Lisa-zhu-zz65/ENG301/README.md

# Music Bracelet Project
Repository for the music bracelet project, with hardware and software work detailed. \
Project_1 folder contains all the files created and used in the music bracelet prototype.\
Project_2 folder contains all the files created for the music bracelet PCB design.
