Lisa-zhu-zz65/ENG301/Project_2/docs/Lisa Zhu Project 2 proposal.pptx

## ENGI 301 <Music Bracelet> PCB Proposal

<Nov 16th 2021>
<Lisa Zhu>

## Background Information

- What is being proposed?
  - Lisa-zhu-zz65/ENGI301 (github.com) (https://github.com/Lisa-zhu-zz65/ENGI301)
  - Music Bracelet - Hackster.io (https://www.hackster.io/lisa-zhu/music-bracelet-0456b9)
- What changes (if any) are you going to make based on your prototype?
  - Change the USB speaker to a Bluetooth speaker
  - Get power from a battery instead of wall outlet
  - Reduce the size of the screen
  - Smaller Breadboard

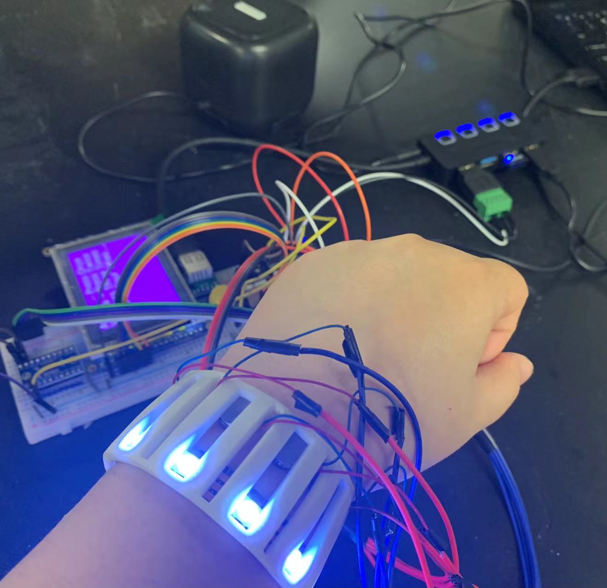
[picture p1: figure]

## System Block Diagram

Battery

Pocket Beagle

RGB LED Strip

VIN

VOUT

SPI

GND

PWM

Vibrating Mini Motor Discs

USB breakout board

Bluetooth Adaptor

Button

GPIO

USB1

Adafruit 1.8" TFT Display Breakout and Shield

SPI

## Mechanical Block Diagram

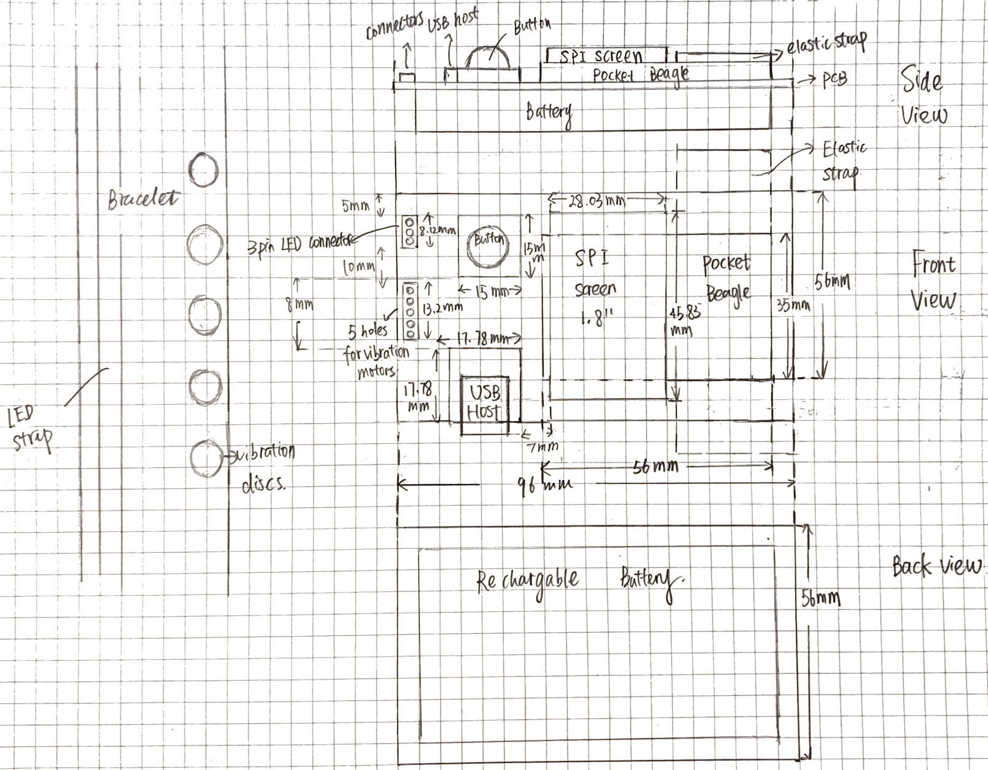
[picture p2: figure]

## Components Required

- Create a list of all the components that you require for the PCB
  - USB Host connector
  - TXS0108E Level Shifter
  - Power connector
  - 3-pin 100-mil Strip LED connector
  - LED strip
  - Button
  - Bluetooth adaptor
  - 1.8" TFT Display Breakout and Shield
  - Vibration discs
