Lisa-zhu-zz65/ENG301/Project_1/docs/Zhu_ENGI301_project_proposal.pptx

## ENGI 301 Haptic Music Player Proposal

10/5/2021
Lisa Zhu

## Background Information

- What is being proposed?
  - I want to build a wearable haptic wristband that can produce vibration cues that enable the user to feel the music while listening to music; a LED strip is decorated on the wristband to provide visual effects in response to the music.
  - I am a rock fan and I really enjoy live house performances; the main reason is that in such environment, audience can feel the vibrations from the speaker and visual simulations in addition to audio effects, and the experience is more engaging. Now with the pandemic, it’s harder to “feel” the music in person, and I think the haptic wristband can bring that combination of senses back.
  - A rendering framework for producing vibration cues: https://www.syntacts.org/
  - Inspired by the project: Pocketbeagle (https://www.hackster.io/juliana-wang/pocketbeagle-led-music-visualizer-3e6c7c) LED Music Visualizer - Hackster.io (https://www.hackster.io/juliana-wang/pocketbeagle-led-music-visualizer-3e6c7c)
- What improvements / additions over existing project
  - The motivating project doesn’t have vibration units and isn’t portable/ wearable, which I’ll be improving in my project.

## System Block Diagram

Pocket Beagle

VOUT

RGB LED Strip

GND

SPI

Vibrating Mini Motor Discs

PWM

USB breakout board

USB to micro USB hub

USB speaker

Buttons

GPIO

USB1

SPI

Adafruit 2.0" 320x240 Color IPS TFT Display

## Power Block Diagram

Pocket Beagle

VOUT/3.3V

5V, rated current unknown

RGB LED Strip

VOUT

3.3V, <60 mA each

Vibrating Mini Motor Discs

3.3V

Adafruit 2.0" 320x240 Color IPS TFT Display

Work with 3.3-5V

USB speaker

5V, 2x2W

Notes: 500mA max

## Components / Budget

Component | Need to Buy | Cost
Vibrating Mini Motor Disc : ID 1201 : $1.95 : Adafruit Industries, Unique & fun DIY electronics and kits (https://www.adafruit.com/product/1201) | 6 | $1.95 each
Amazon.com : ALITOVE 3.2ft 60 Pixels WS2812B Individual Addressable RGB LED Strip Light Programmable WS2811 IC Built-in 5050 LED Rope Lamp DC5V Black PCB Non-Waterproof Compatible with Arduino, Raspberry Pi : Home & Kitchen (https://www.amazon.com/ALITOVE-Individual-Addressable-Programmable-Non-Waterproof/dp/B01MG49QKD?s=lamps-light) | 1 | $9.99
2.0 320x240 Color IPS TFT Display with microSD Card Breakout : ID 4311 : $19.95 : Adafruit Industries, Unique & fun DIY electronics and kits (https://www.adafruit.com/product/4311) | 1 | $19.95
Mini External USB Stereo Speaker : ID 3369 : $12.50 : Adafruit Industries, Unique & fun DIY electronics and kits (https://www.adafruit.com/product/3369) | 1 | $12.5
USB Mini Hub with Power Switch - OTG Micro-USB : ID 2991 : $5.95 : Adafruit Industries, Unique & fun DIY electronics and kits (https://www.adafruit.com/product/2991) | 1 | %5.95
USB Micro-B Breakout Board : ID 1833 : $1.50 : Adafruit Industries, Unique & fun DIY electronics and kits (https://www.adafruit.com/product/1833) | 1 | $1.5
Amazon.com: 4 Pieces Carpal Tunnel Wrist Brace, Wrist Compression Strap, Hand Brace Wraps for Adult Working Out, Adjustable Wrist Strap, Breathable Wristband for Weightlifting, Tennis, Golf and Fitness, Black : Health & Household (https://www.amazon.com/Compression-Adjustable-Breathable-Wristband-Weightlifting/dp/B092QBG462) | 1 | $6.99
