Lisa-zhu-zz65/ENG301/Project_2/MFG/bottom layer gerber.png

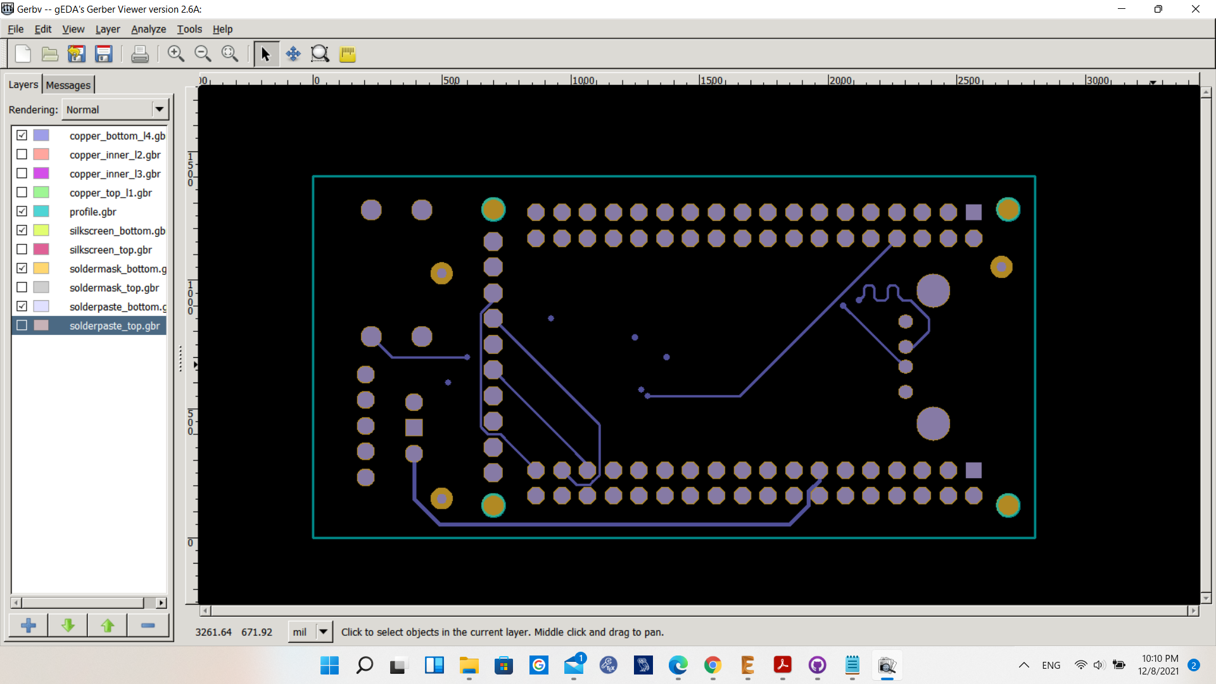
Project_2/MFG/bottom layer gerber.png
