Lisa-zhu-zz65/ENG301/Project_2/MFG/BOM.csv

Qty | Value | Device | Package | Parts | Description | AVAILABILITY | DESCRIPTION | HOUSEPART | MF | MP | MPN | PACKAGE | POPULATE | PRICE | PURCHASE-URL | TOLERANCE | URL | VOLTAGE
1 |  | CAPACITOR_P_10MM | CP10MM | C1 | Library: MF_Passives |  |  |  |  |  |  |  | 1
1 | 1k | R_R0603 | R0603 | R1 | RESISTOR, American symbol
6 | FIDUCIAL | FIDUCIAL | FIDUCIAL_40MIL | FUD1, FUD2, FUD3, FUD4, FUD5, FUD6
1 | LED_STRIP | LED_STRIP | LED_HEADERS | U2 | LED Strip
1 | POCKETBEAGLE | POCKETBEAGLE | POCKETBEAGLE | U1
1 | PUSH_BUTTON | PUSH_BUTTON | BUTTON_12.5MM | SW1
1 | SPI_DISPLAY | SPI_DISPLAY | SPI_DISPLAY | U3 | 1.8 Color TFT LCD display"
1 | TXS0108EPWR | TXS0108EPWR | SOP65P640X120-20N | U4 | Check prices | In Stock | 8-bit bidirectional voltage-level shifter for open-drain and push-pull application 20-TSSOP -40 to 85 |  | Texas Instruments | TXS0108EPWR |  | TSSOP-20 Texas Instruments |  | None | https://pricing.snapeda.com/search/part/TXS0108EPWR/?ref=eda
1 | USB_SPEAKER | USB_SPEAKER | USB_CONNECTOR | U5
1 | VIBRATOR | VIBRATOR | VIBRATOR_HEADERS | U6 | Vibration motor
