Lisa-zhu-zz65/ENG301/Project_2/project2_schematics.pdf

PocketBeagle | LED Strip | Level Shifter
3.3V P2_23 | SPI1.MOSI P2_25 | SPI1.MISO P2_27 | SPI1.CLK P2_29 | GPIO19 P2_31 | GPIO45 P2_33 | GPIO86 P2_35 | GPIO59 | P2_02 GPIO58 | P2_04 GPIO57 | P2_06 GPIO60 | P2_08 GPIO52 | P2_10 PWR.BTN P2_12 | BAT.VIN P2_14 | BAT.TEMP P2_16 | GPIO47 | P2_18 GPIO64 | P2_20 GPIO46 | P2_22 GPIO44 | P2_24 RESET# P2_26 | AIN.VREF- P1_17 | AIN0(1.8V) P1_19 | AIN1(1.8V) P1_21 | AIN2(1.8V) P1_23 | AIN3(1.8V) P1_25 | AIN4(1.8V) P1_27 | PRU0.7 | P1_29 PRU0.4 | P1_31 PWM0B | P1_33 PRU1.10 | P1_35 AIN.VREF+ P1_18 | PRU0.6 | P2_28 PRU0.3 | P2_30 PRU0.2 | P2_32 PRU0.5 | P2_34 AIN7(1.8V) P2_36

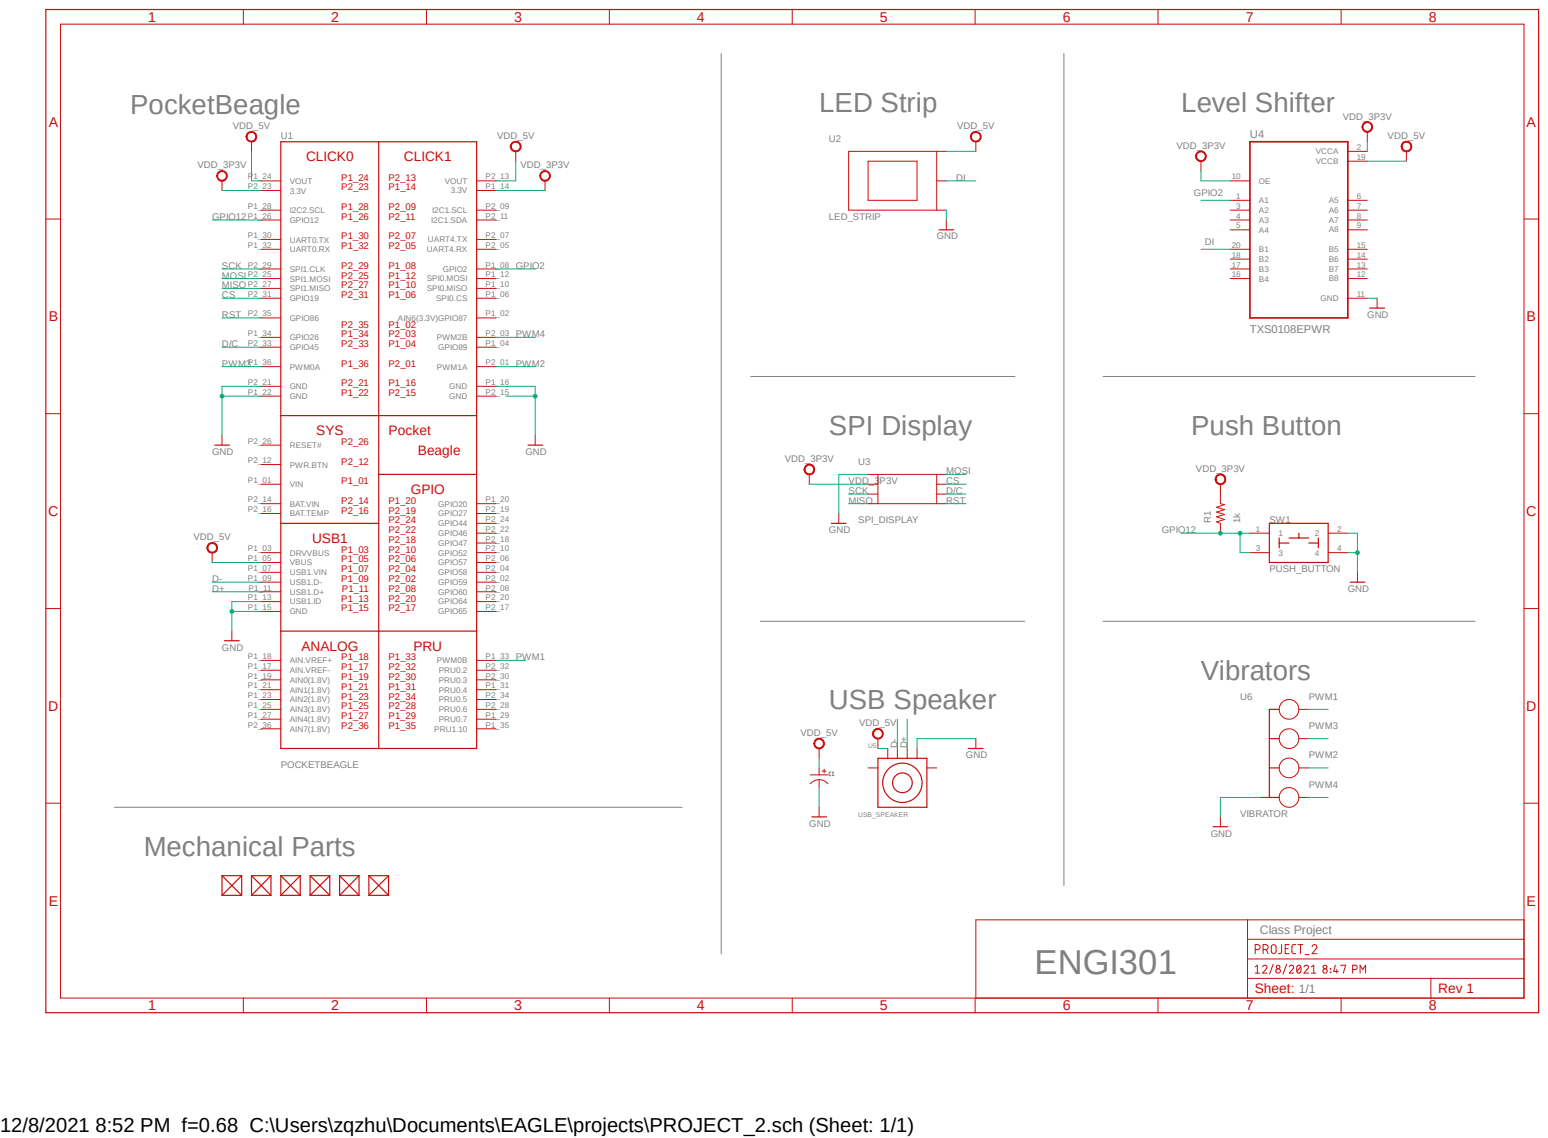
[picture p4: page 1]
SPI Display; Push Button; Vibrators; USB Speaker; Mechanical Parts; LED_STRIP; SPI_DISPLAY; TXS0108EPWR; USB_SPEAKER; VIBRATOR; SW1 PUSH_BUTTON ¹k; GND; VDD_3P3V; VDD_5V; VDD_3P3V GND; VDD_5V GND; VIN P1_01; DRVVBUS P1_03; VBUS P1_05; USB1.VIN P1_07; USB1.D- P1_09; USB1.D+ P1_11; USB1.ID P1_13; GND P1_15; AIN6(3.3V)GPIO87; P1_02 GPIO89; P1_04 SPI0.CS; P1_06 GPIO2; P1_08 SPI0.MISO; P1_10 SPI0.MOSI; P1_14 GND; P1_16 GPIO20; P1_20 GND P2_21; VOUT P1_24; GPIO12 P1_26; I2C2.SCL P1_28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

Class Project POCKETBEAGLE

ENGI301

Sheet: 1/1 | Rev 1

12/8/2021 8:52 PM f=0.68 C:\Users\zqzhu\Documents\EAGLE\projects\PROJECT_2.sch (Sheet: 1/1)
