Lisa-zhu-zz65/ENG301/Project_2/docs/top layer layout.pdf

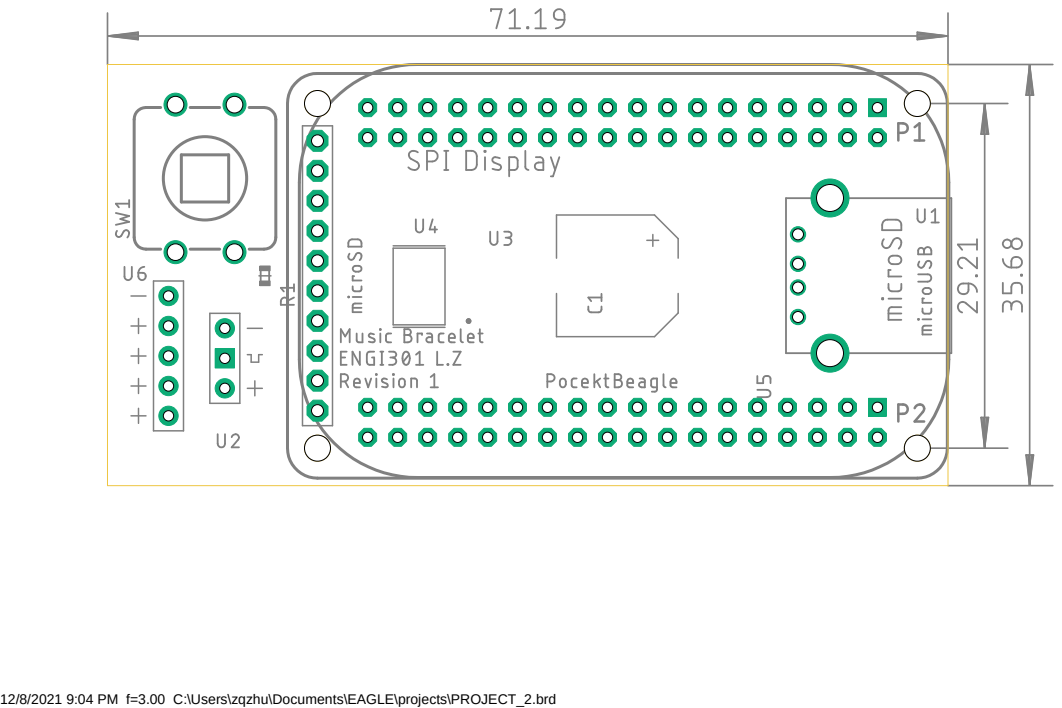
[picture p6: page 1]

12/8/2021 9:04 PM f=3.00 C:\Users\zqzhu\Documents\EAGLE\projects\PROJECT_2.brd
