Lisa-zhu-zz65/ENG301/Project_2/EAGLE/PROJECT_2.brd

## EAGLE design Project_2/EAGLE/PROJECT_2.brd (2021-12-09)

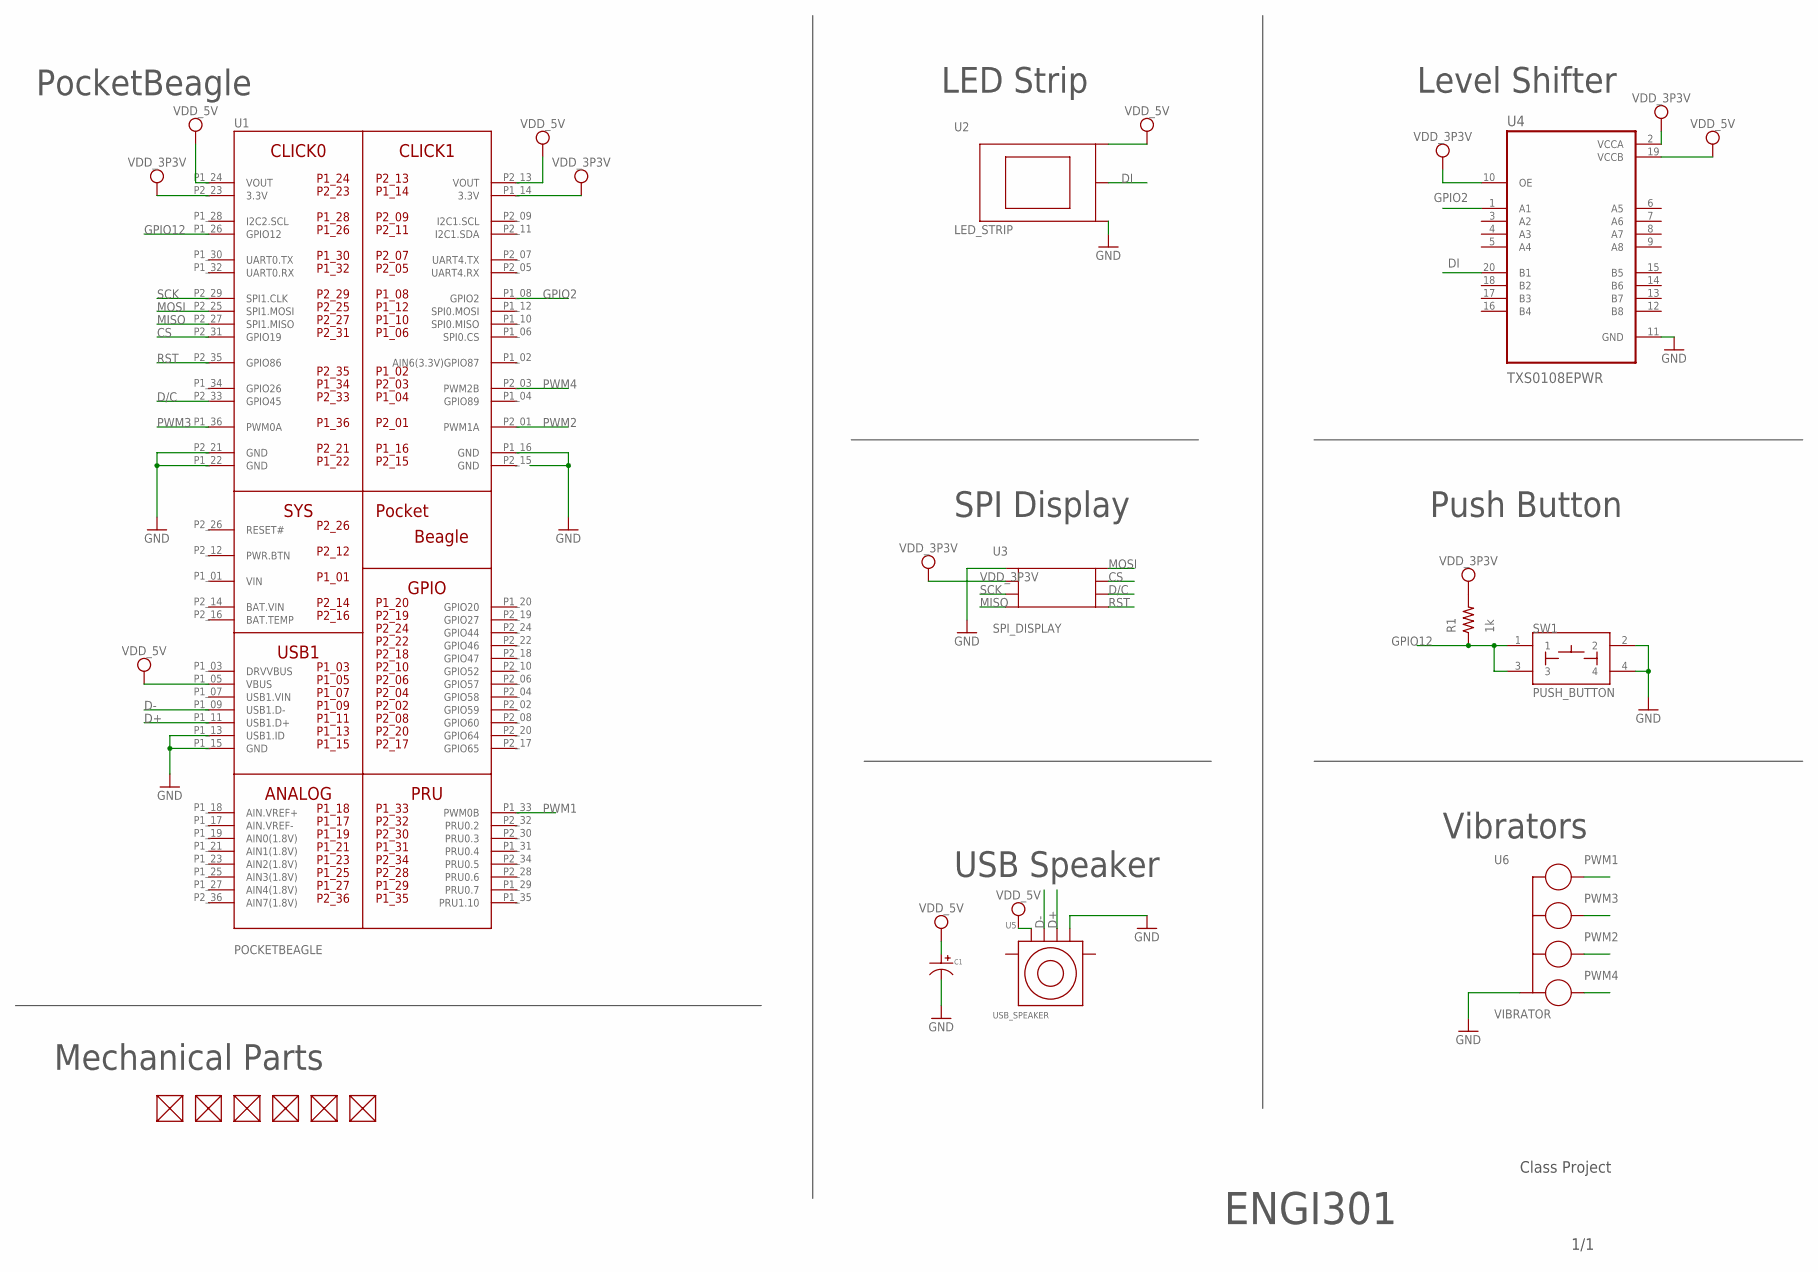
[picture p7: schematic PROJECT_2.sch]

Parts:
C1: CAPACITOR_P_10MM; CP10MM
FUD1, FUD2, FUD3, FUD4, FUD5, FUD6: FIDUCIAL; FIDUCIAL_40MIL
R1: 1k; R0603
SW1: PUSH_BUTTON; BUTTON_12.5MM
U1: POCKETBEAGLE
U2: LED_STRIP; LED_HEADERS
U3: SPI_DISPLAY
U4: TXS0108EPWR; SOP65P640X120-20N
U5: USB_SPEAKER; USB_CONNECTOR
U6: VIBRATOR; VIBRATOR_HEADERS

Connections:
BAT.VIN: U1.P2_14 (BAT.VIN)
CS: U1.P2_31 (GPIO19), U3.TFT-CS (CS)
D+: U1.P1_11 (USB1.D+), U5.D+
D-: U1.P1_09 (USB1.D-), U5.D-
D/C: U1.P2_33 (GPIO45), U3.D/C
DI: U2.SIG, U4.20 (B1)
GND: C1.P$2, SW1.2, SW1.4, U1.P1_13 (USB1.ID), U1.P1_15 (GND), U1.P1_16 (GND), U1.P1_22 (GND), U1.P2_15 (GND), U1.P2_21 (GND), U2.GND, U3.GND, U4.11 (GND), U5.GND, U6.GND
GPIO2: U1.P1_08 (GPIO2), U4.1 (A1)
GPIO12: R1.1, SW1.1, SW1.3, U1.P1_26 (GPIO12)
MISO: U1.P2_27 (SPI1.MISO), U3.MISO
MOSI: U1.P2_25 (SPI1.MOSI), U3.MOSI
PWM1: U1.P1_33 (PWM0B), U6.PWM1
PWM2: U1.P2_01 (PWM1A), U6.PWM3
PWM3: U1.P1_36 (PWM0A), U6.PWM2
PWM4: U1.P2_03 (PWM2B), U6.PWM4
RST: U1.P2_35 (GPIO86), U3.RST
SCK: U1.P2_29 (SPI1.CLK), U3.SCK
VDD_3P3V: R1.2, U1.P1_14 (3.3V), U1.P2_23 (3.3V), U3.VCC, U4.2 (VCCA), U4.10 (OE)
VDD_5V: C1.P$1, U1.P1_05 (VBUS), U1.P1_24 (VOUT), U1.P2_13 (VOUT), U2.PWR (VIN), U4.19 (VCCB), U5.VBUS
VIN: U1.P1_01 (VIN)

Notes on the sheet:
PocketBeagle
LED Strip
Level Shifter
SPI Display
Push Button
Vibrators
USB Speaker
Mechanical Parts
ENGI301
1/1
Class Project

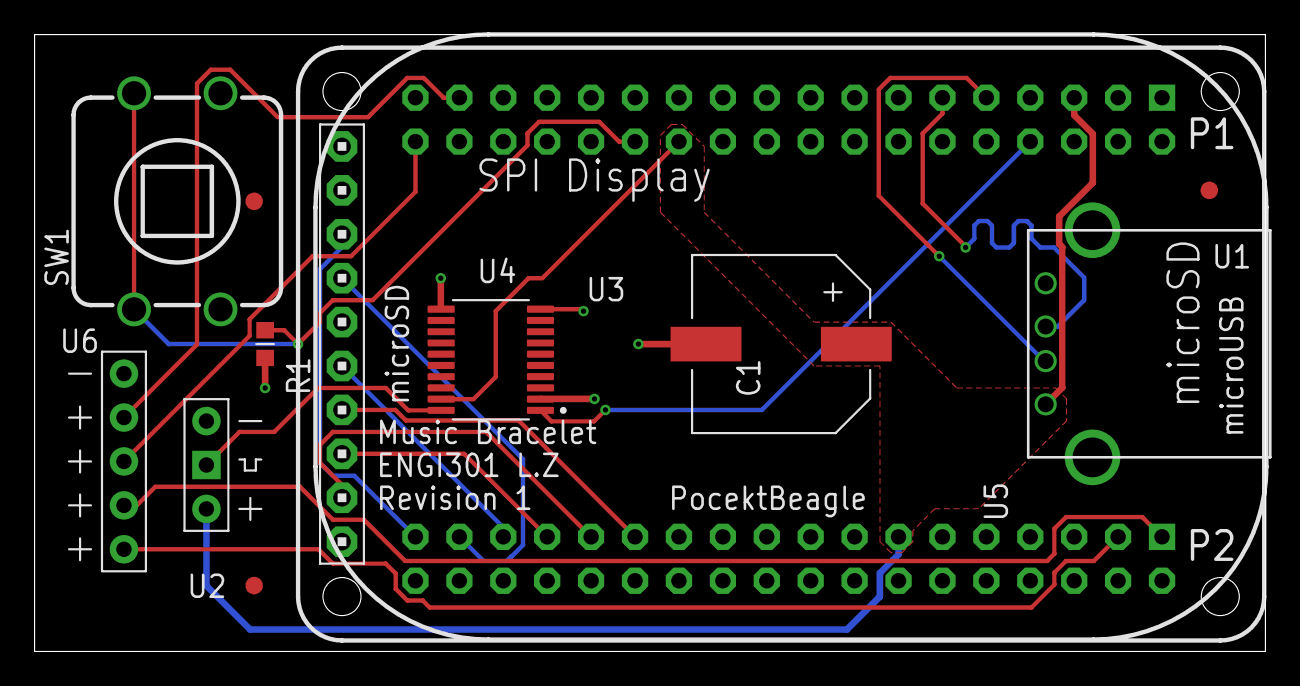
[picture p8: board PROJECT_2.brd from above]

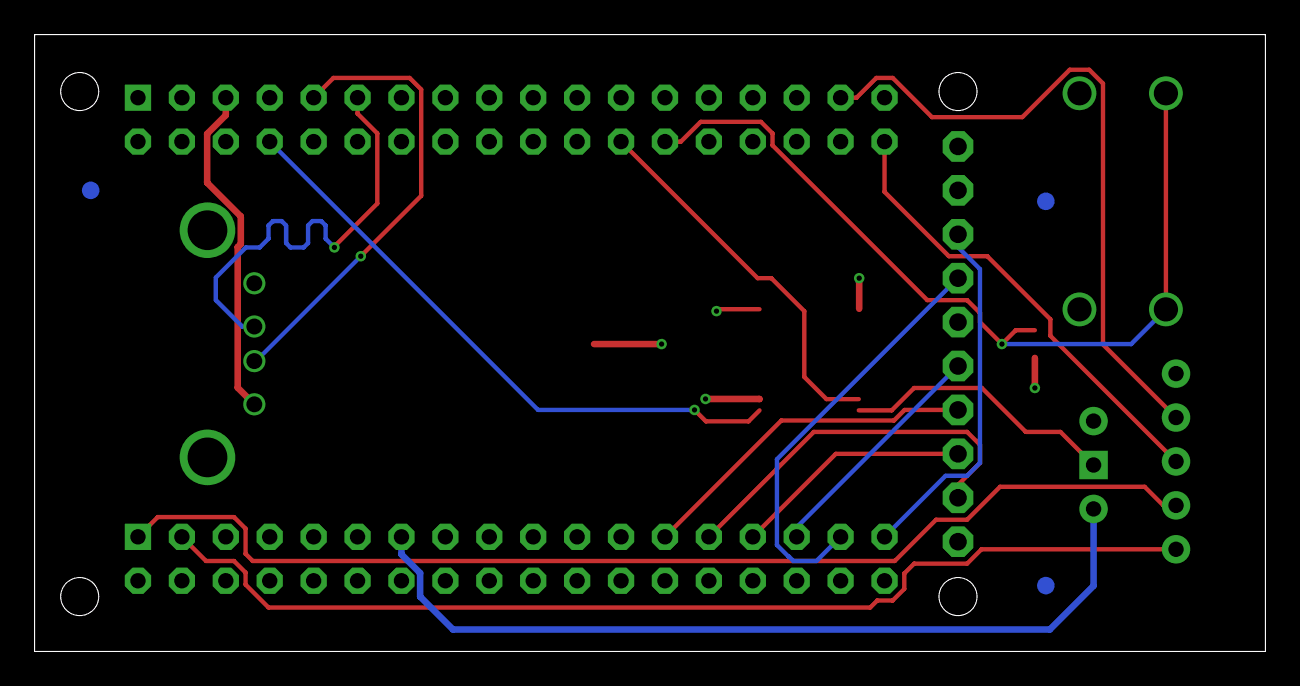
[picture p9: board PROJECT_2.brd from below]

Board: 4 copper layers, 71.2 x 35.7 mm, 15 parts (3 on the bottom side), 18 nets.
