Lisa-zhu-zz65/ENG301/(commit log)

2021-10-05 Create simple_calc_HW.py
    add left shift, right shift, power, modulo, and compatible with python 2 input
2021-10-05 Create blink_USR3.py
    add blink user LED 5 hz file
2021-12-09 Project_2 files
    [BOM.csv, PROJECT_2.brd, PROJECT_2.sch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]
